4x1md/as5040-tester/docs/as5040-sensor-daisy-chain-connection.png

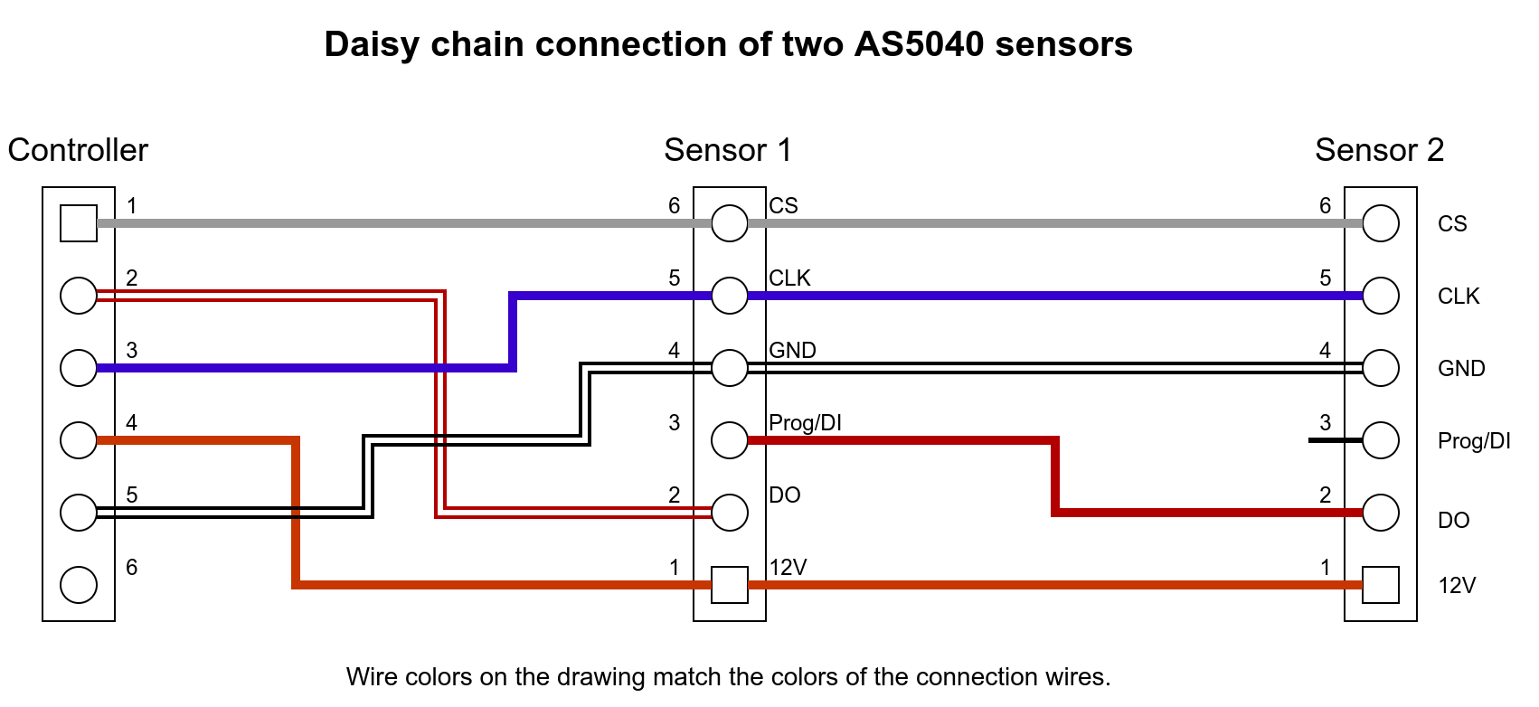
docs/as5040-sensor-daisy-chain-connection.png
