4x1md/as5040-tester/docs/atmega-sensor-connection.png

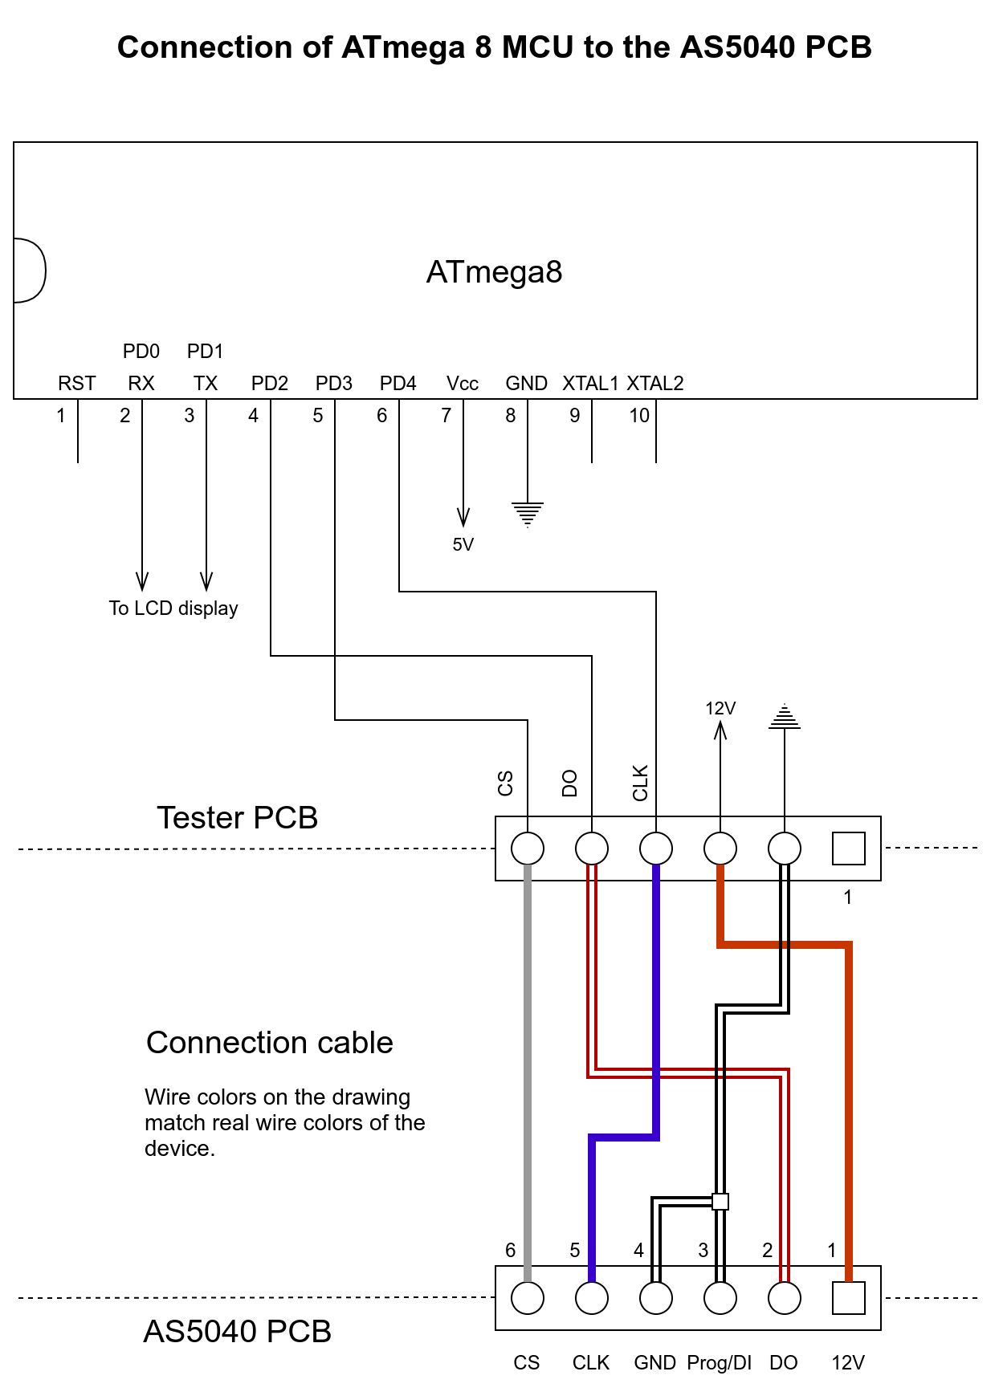
docs/atmega-sensor-connection.png
