4x1md/as5040-tester/schematics/as5040-tester-v1/as5040-tester-v1.kicad_pcb

## KiCad design eda/embedded_prog/embedded_prog.sch

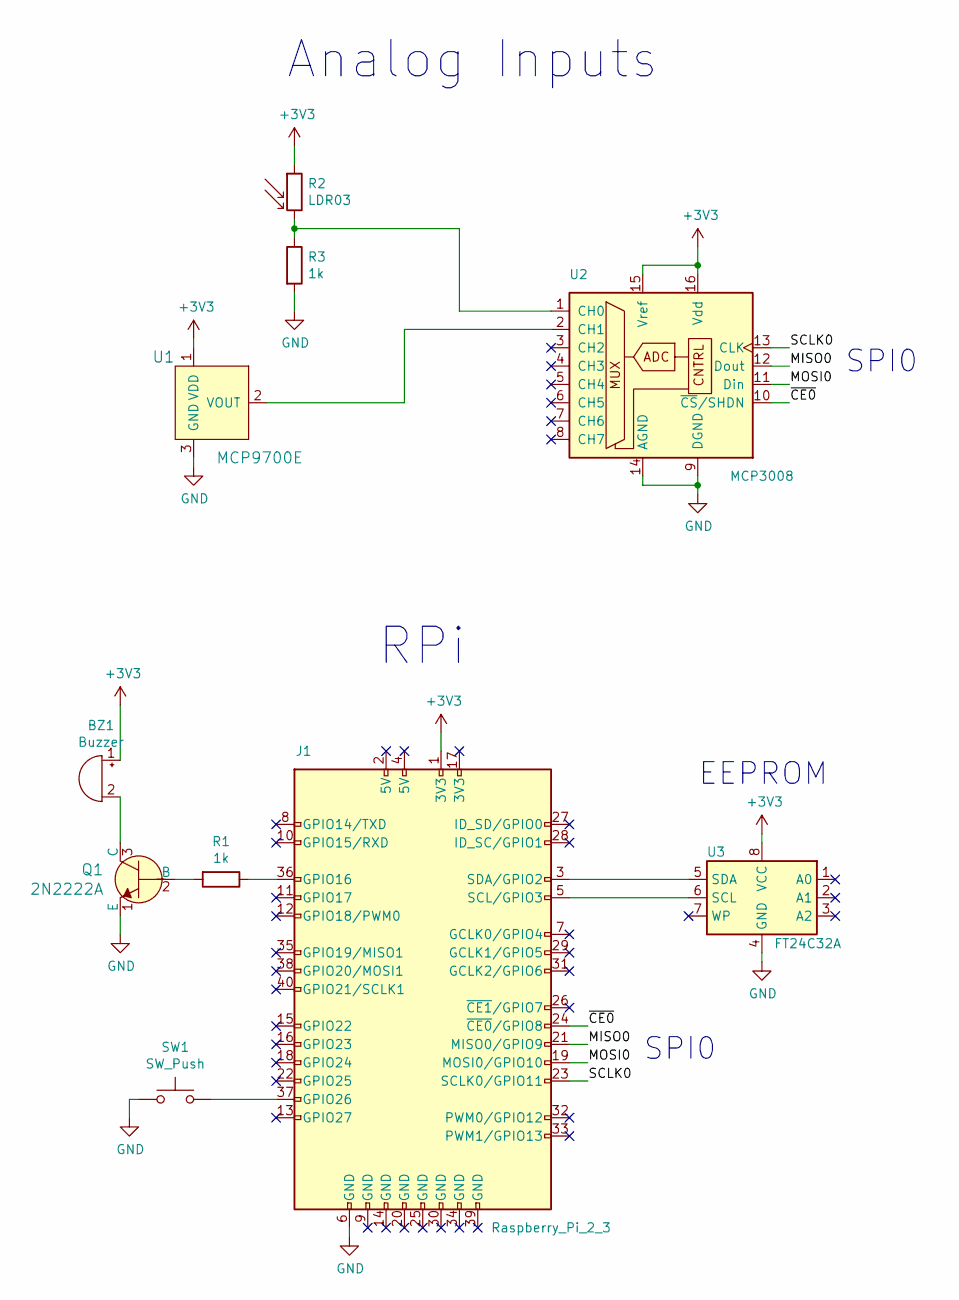
[picture p7: schematic embedded_prog.sch]

Parts:
BZ1: Buzzer
J1: Raspberry_Pi_2_3
Q1: 2N2222A; TO-18-3; MPN 2N2222A; Digi-Key_PN 2N2222ACS-ND
R1, R3: 1k
R2: LDR03; R_LDR_10x8.5mm_P7.6mm_Vertical
SW1: SW_Push
U1: MCP9700E; TO-92-3; MPN MCP9700A-E/TO; Digi-Key_PN MCP9700A-E/TO-ND
U2: MCP3008
U3: FT24C32A

Connections:
+3V3: BZ1.1 (-), J1.1 (3V3), R2.1, U1.1 (VDD), U2.15 (Vref), U2.16 (Vdd), U3.8 (VCC)
GND: J1.6 (GND), Q1.1 (E), R3.2, SW1.1, U1.3 (GND), U2.9 (DGND), U2.14 (AGND), U3.4 (GND)
MISO0: J1.21 (MISO0/GPIO9), U2.12 (Dout)
MOSI0: J1.19 (MOSI0/GPIO10), U2.11 (Din)
unnamed: BZ1.2 (+), Q1.3 (C)
unnamed: J1.3 (SDA/GPIO2), U3.5 (SDA)
unnamed: J1.5 (SCL/GPIO3), U3.6 (SCL)
unnamed: J1.36 (GPIO16), R1.1
unnamed: J1.37 (GPIO26), SW1.2
unnamed: Q1.2 (B), R1.2
unnamed: R2.2, R3.1, U2.1 (CH0)
unnamed: U1.2 (VOUT), U2.2 (CH1)
SCLK0: J1.23 (SCLK0/GPIO11), U2.13 (CLK)
~CE0: J1.24 (~CE0~/GPIO8), U2.10 (~CS~/SHDN)

Notes on the sheet:
Analog Inputs
SPI0
EEPROM
RPi
