4x1md/as5040-tester/docs/as5040-tester-v1.png

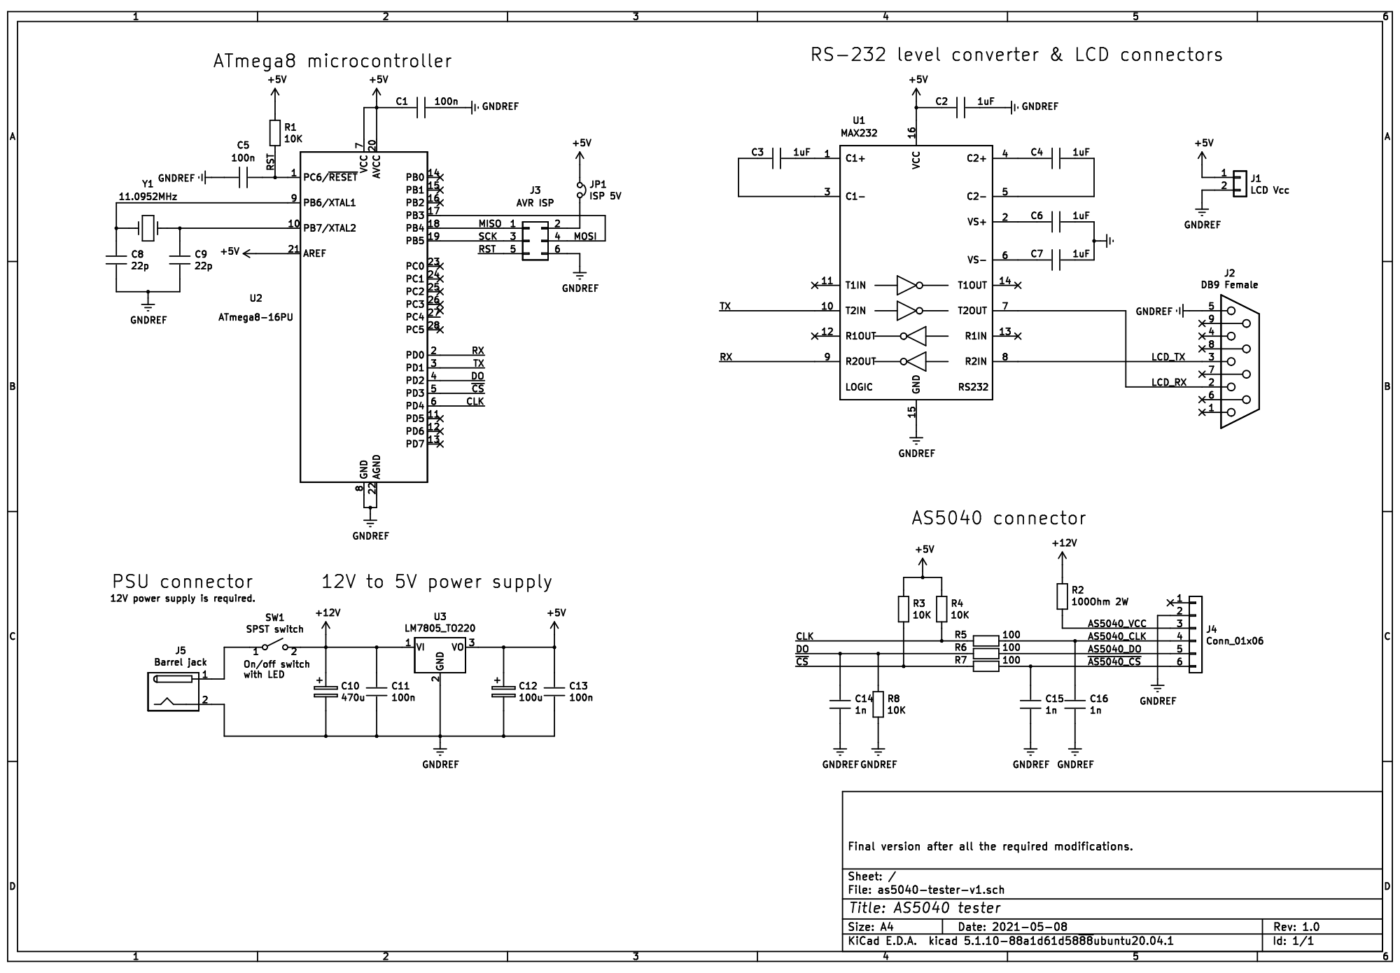
docs/as5040-tester-v1.png
