4x1md/as5040-tester/images/tester-photo-1.jpg

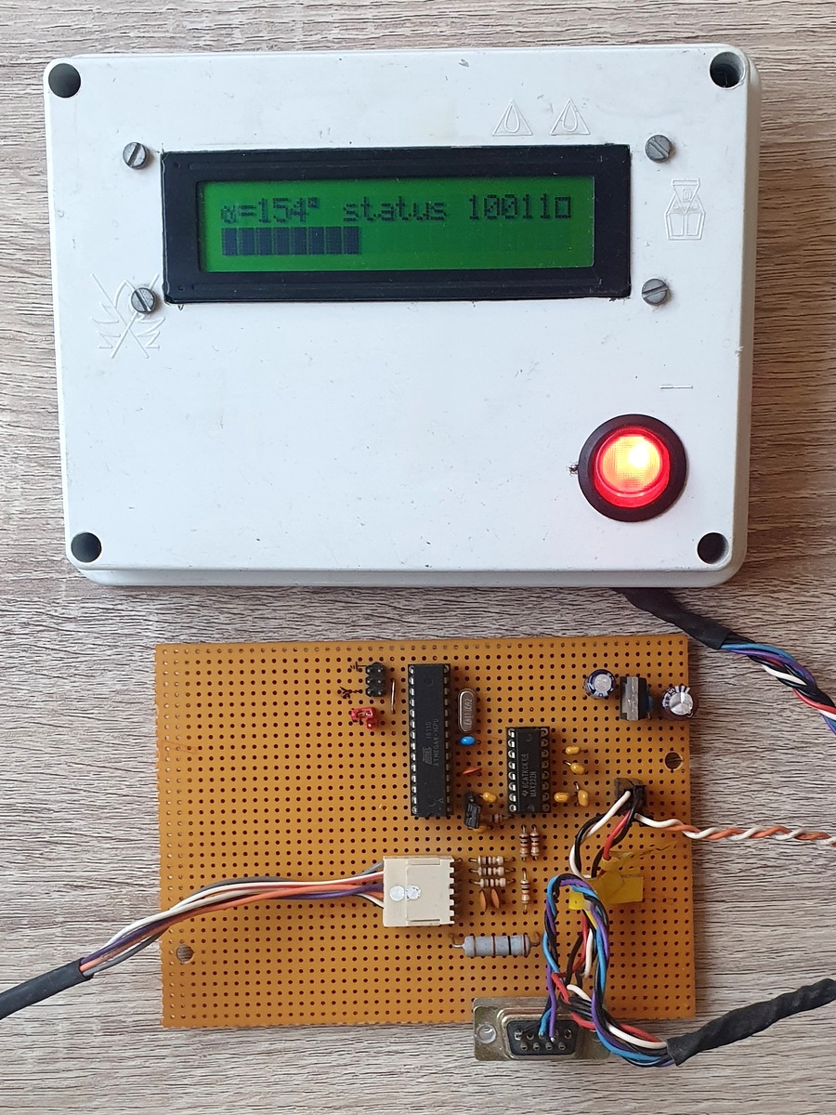
images/tester-photo-1.jpg
