4x1md/as5040-tester/images/tester-photo-2.jpg

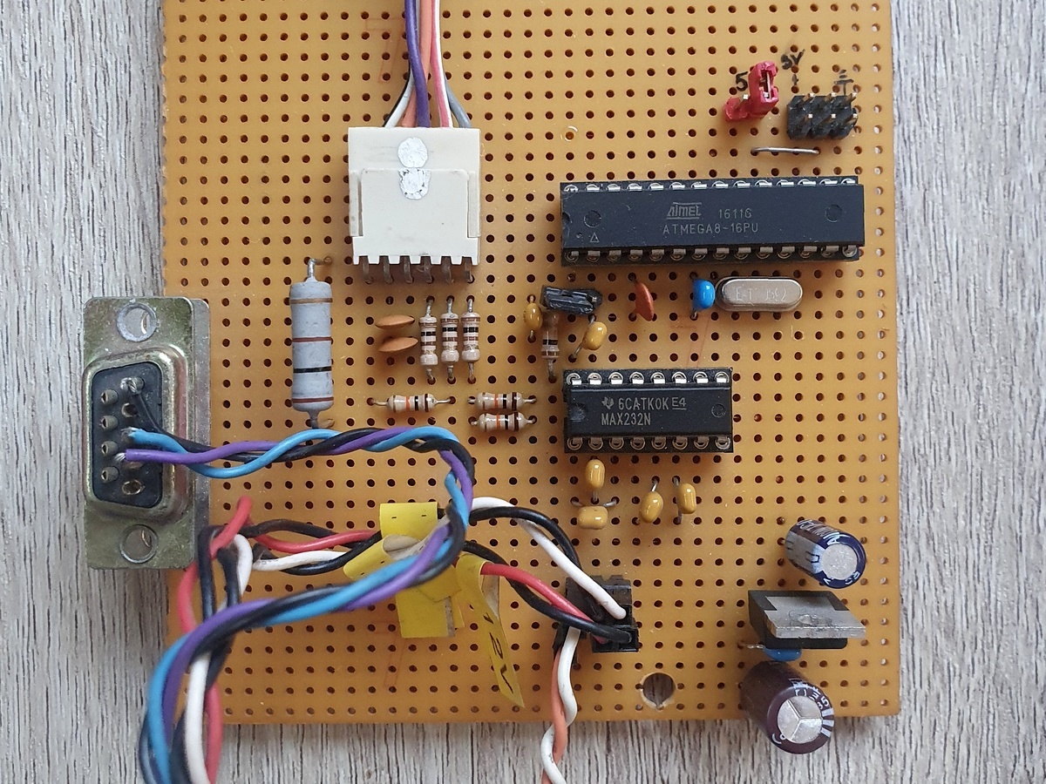
images/tester-photo-2.jpg
